cUDGk/usb-fanctl/preview/a_iso.png

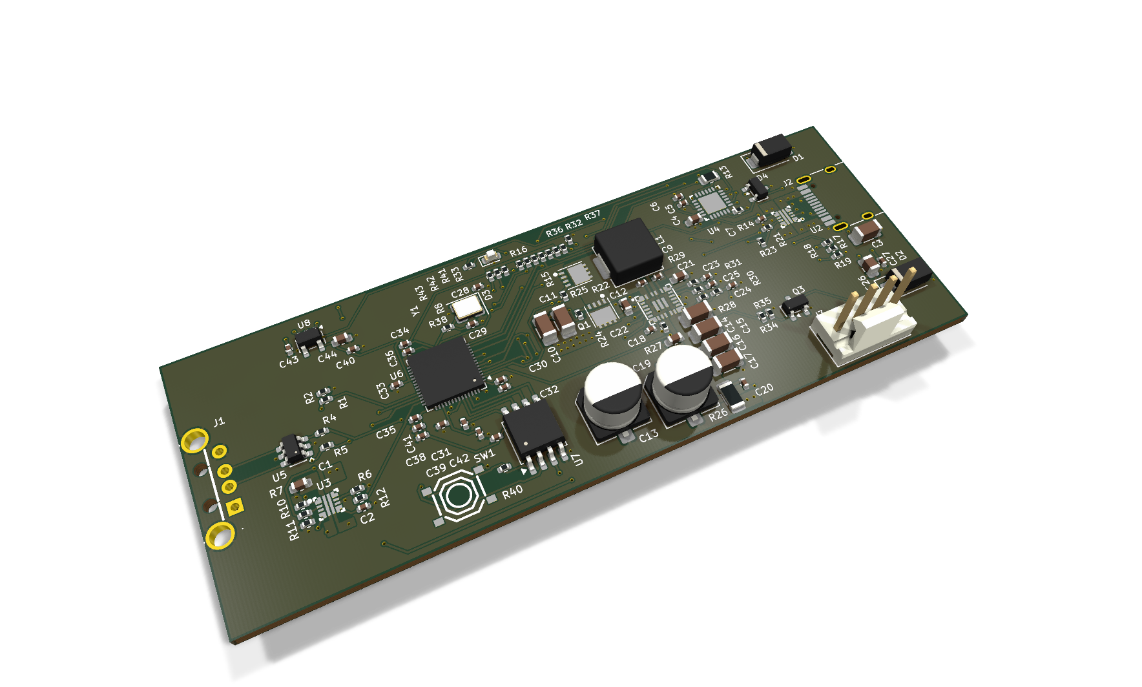
preview/a_iso.png
