cUDGk/usb-fanctl/preview/a_top.png

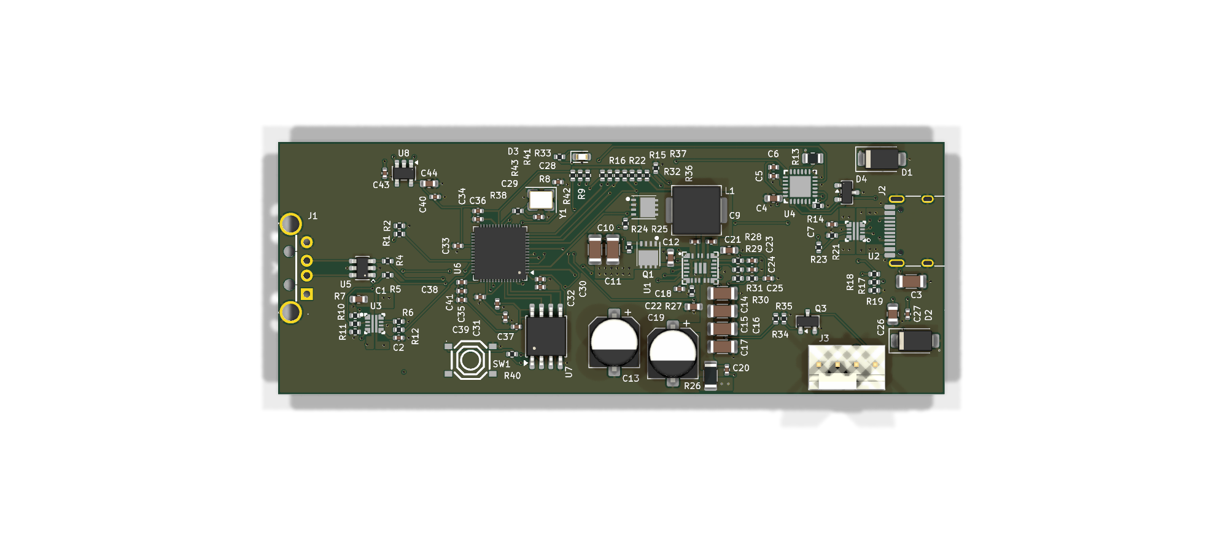
preview/a_top.png
