cUDGk/usb-fanctl/order/fanctl_c/jlc_placement_3d.png

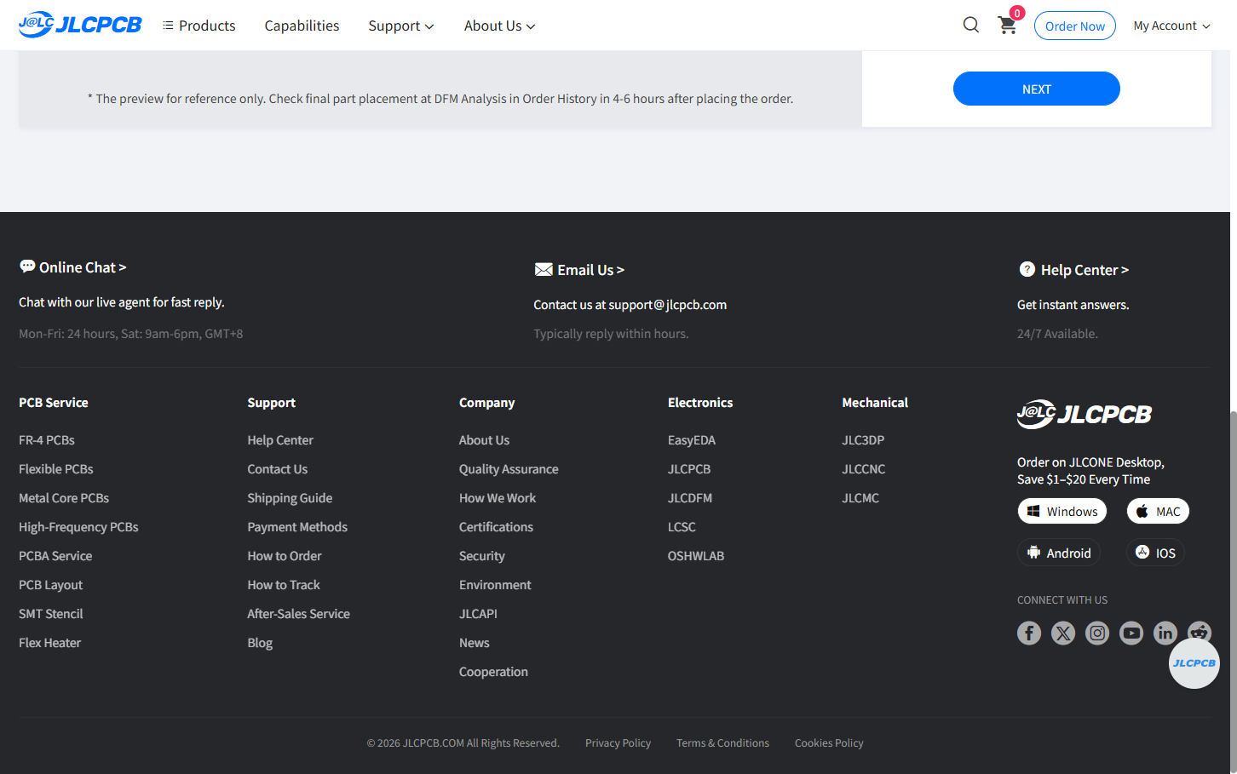
order/fanctl_c/jlc_placement_3d.png
