cUDGk/usb-fanctl/fanctl_c/fanctl_c.kicad_pcb

## KiCad design fanctl_c/fanctl_c.kicad_pcb (2026-09-18)

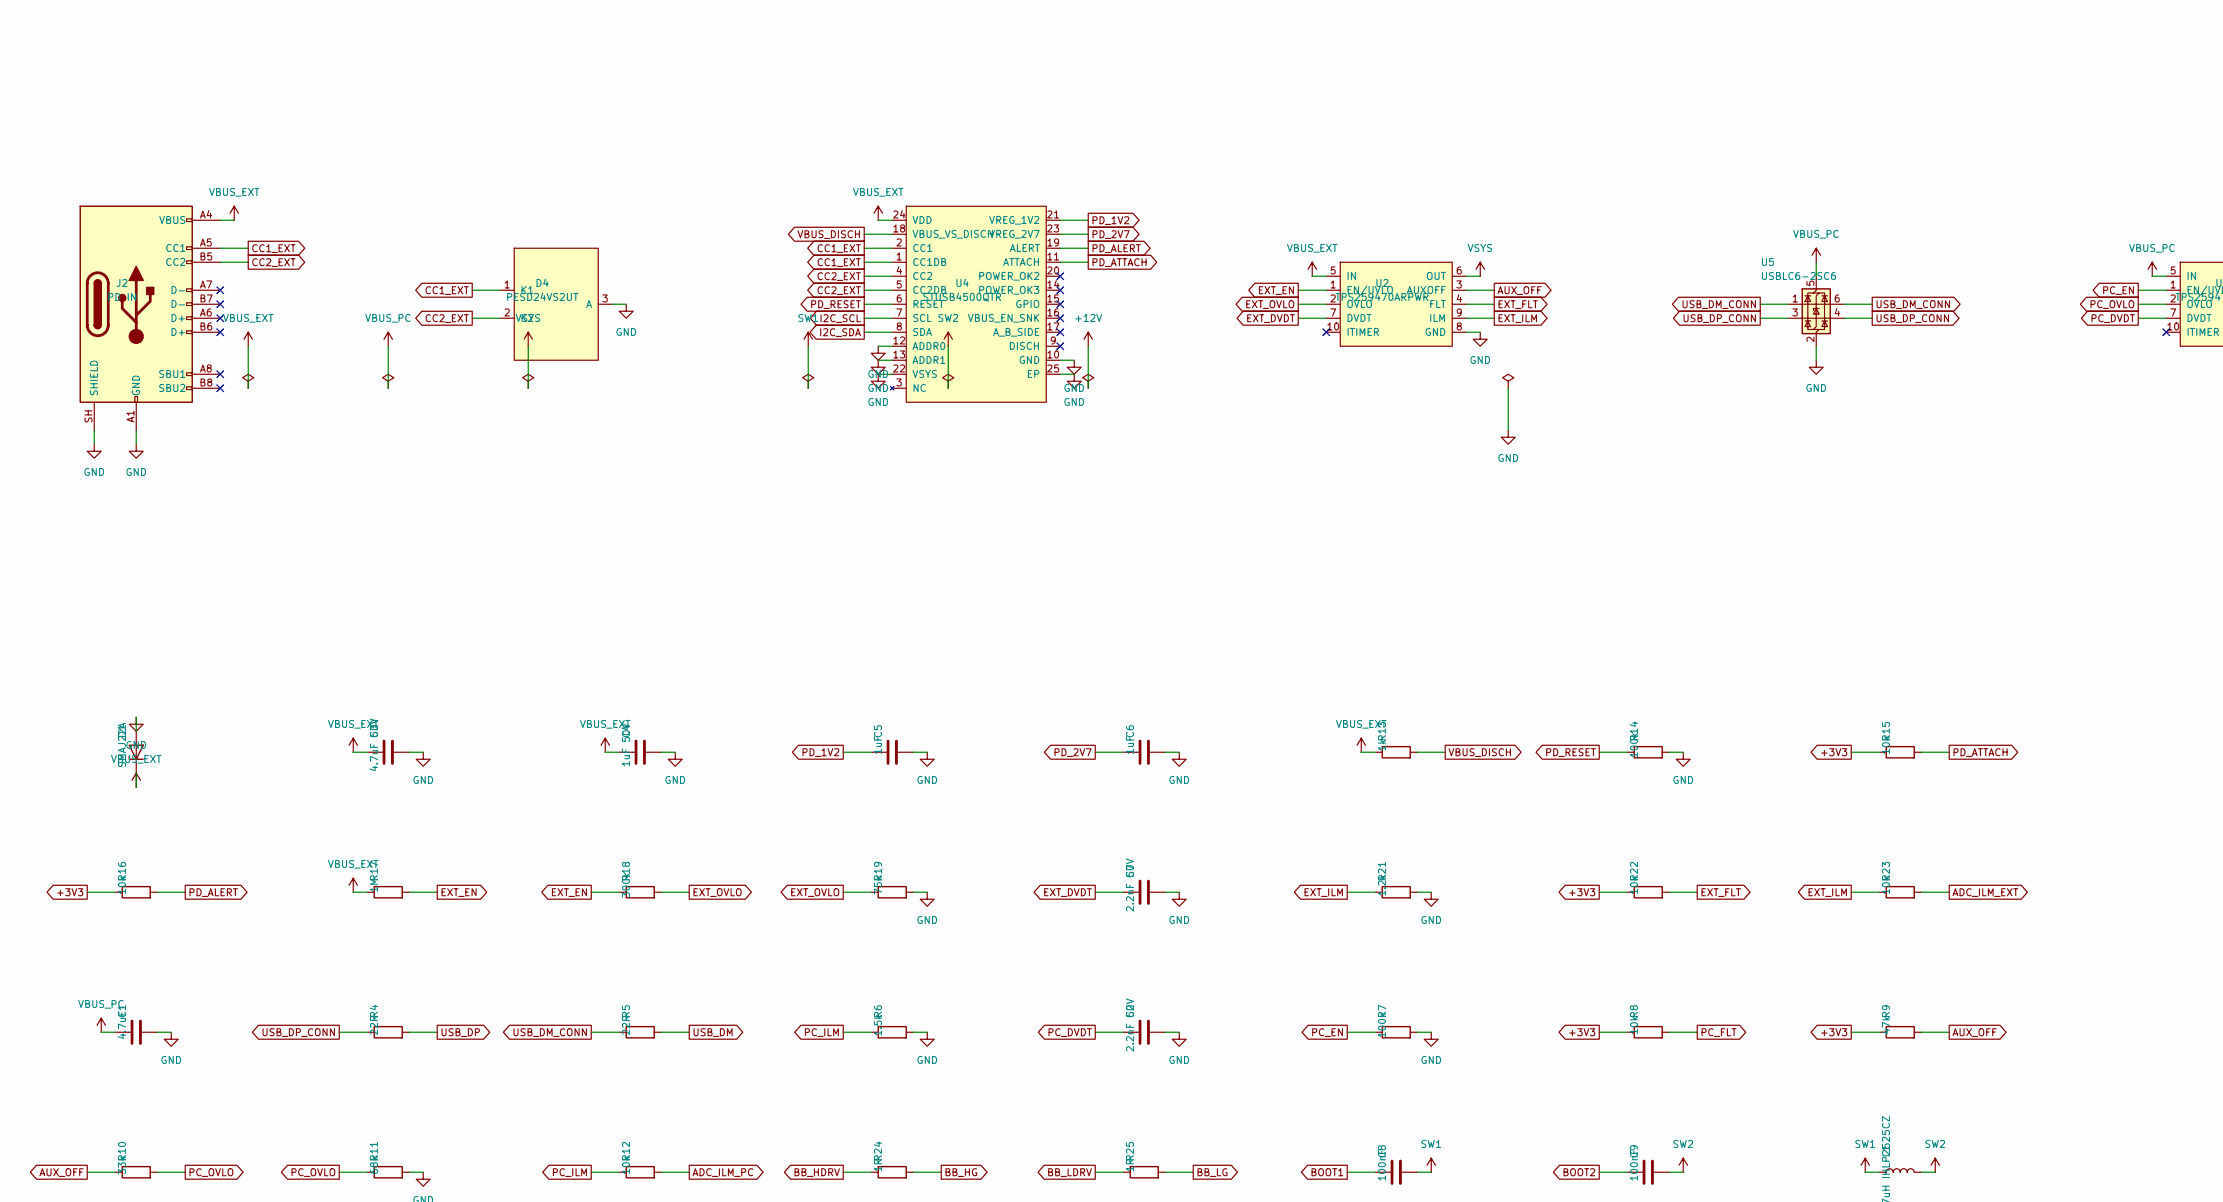
[picture p4: schematic fanctl_c.kicad_sch, USB Fan Controller (C plug), part in row 1, column 1]

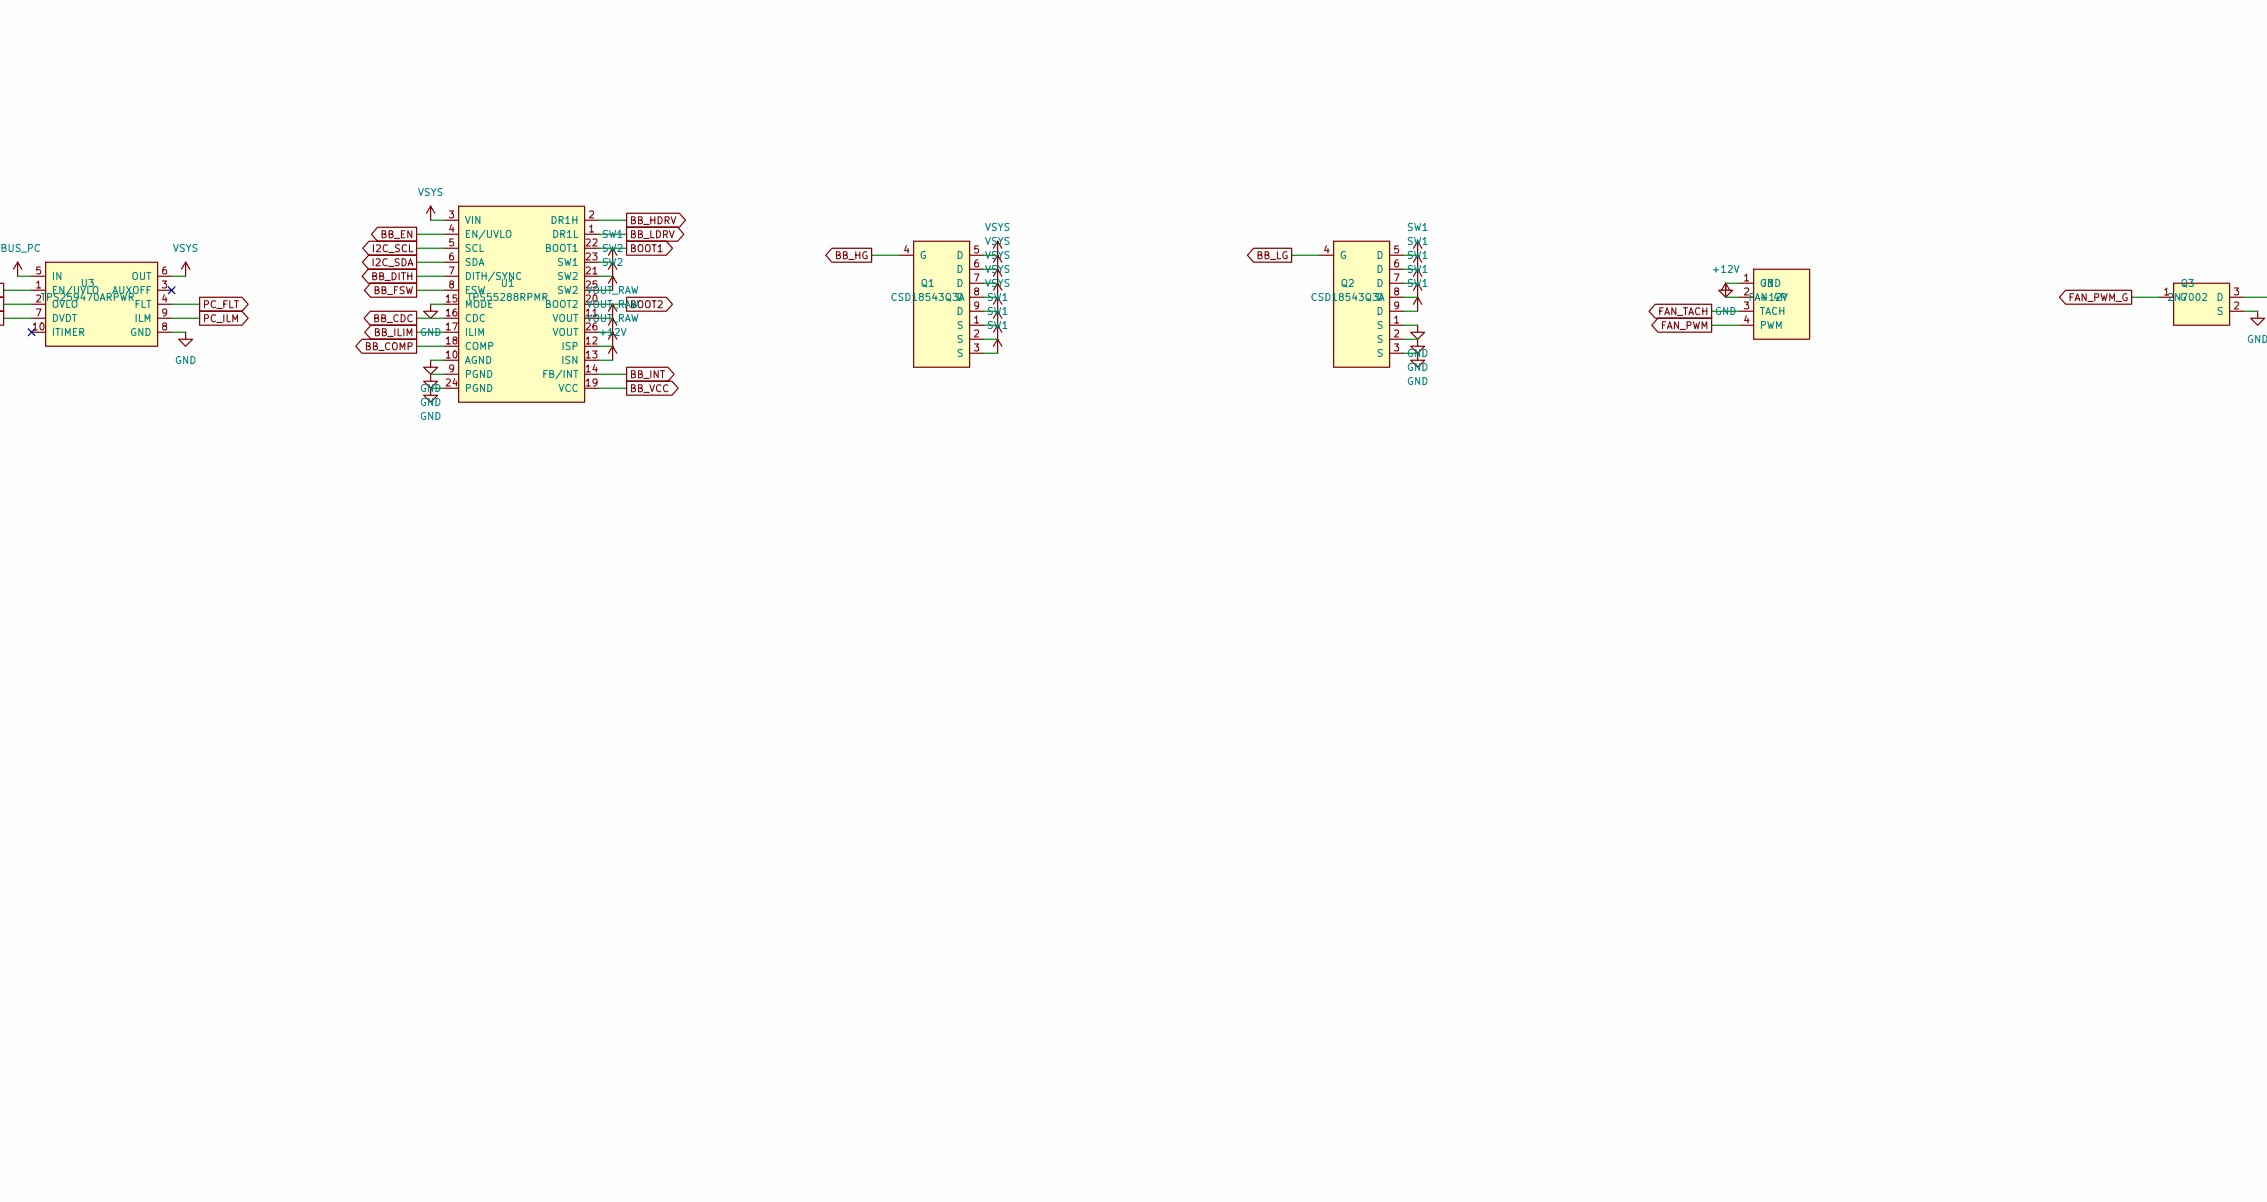
[picture p5: schematic fanctl_c.kicad_sch, USB Fan Controller (C plug), part in row 1, column 2]

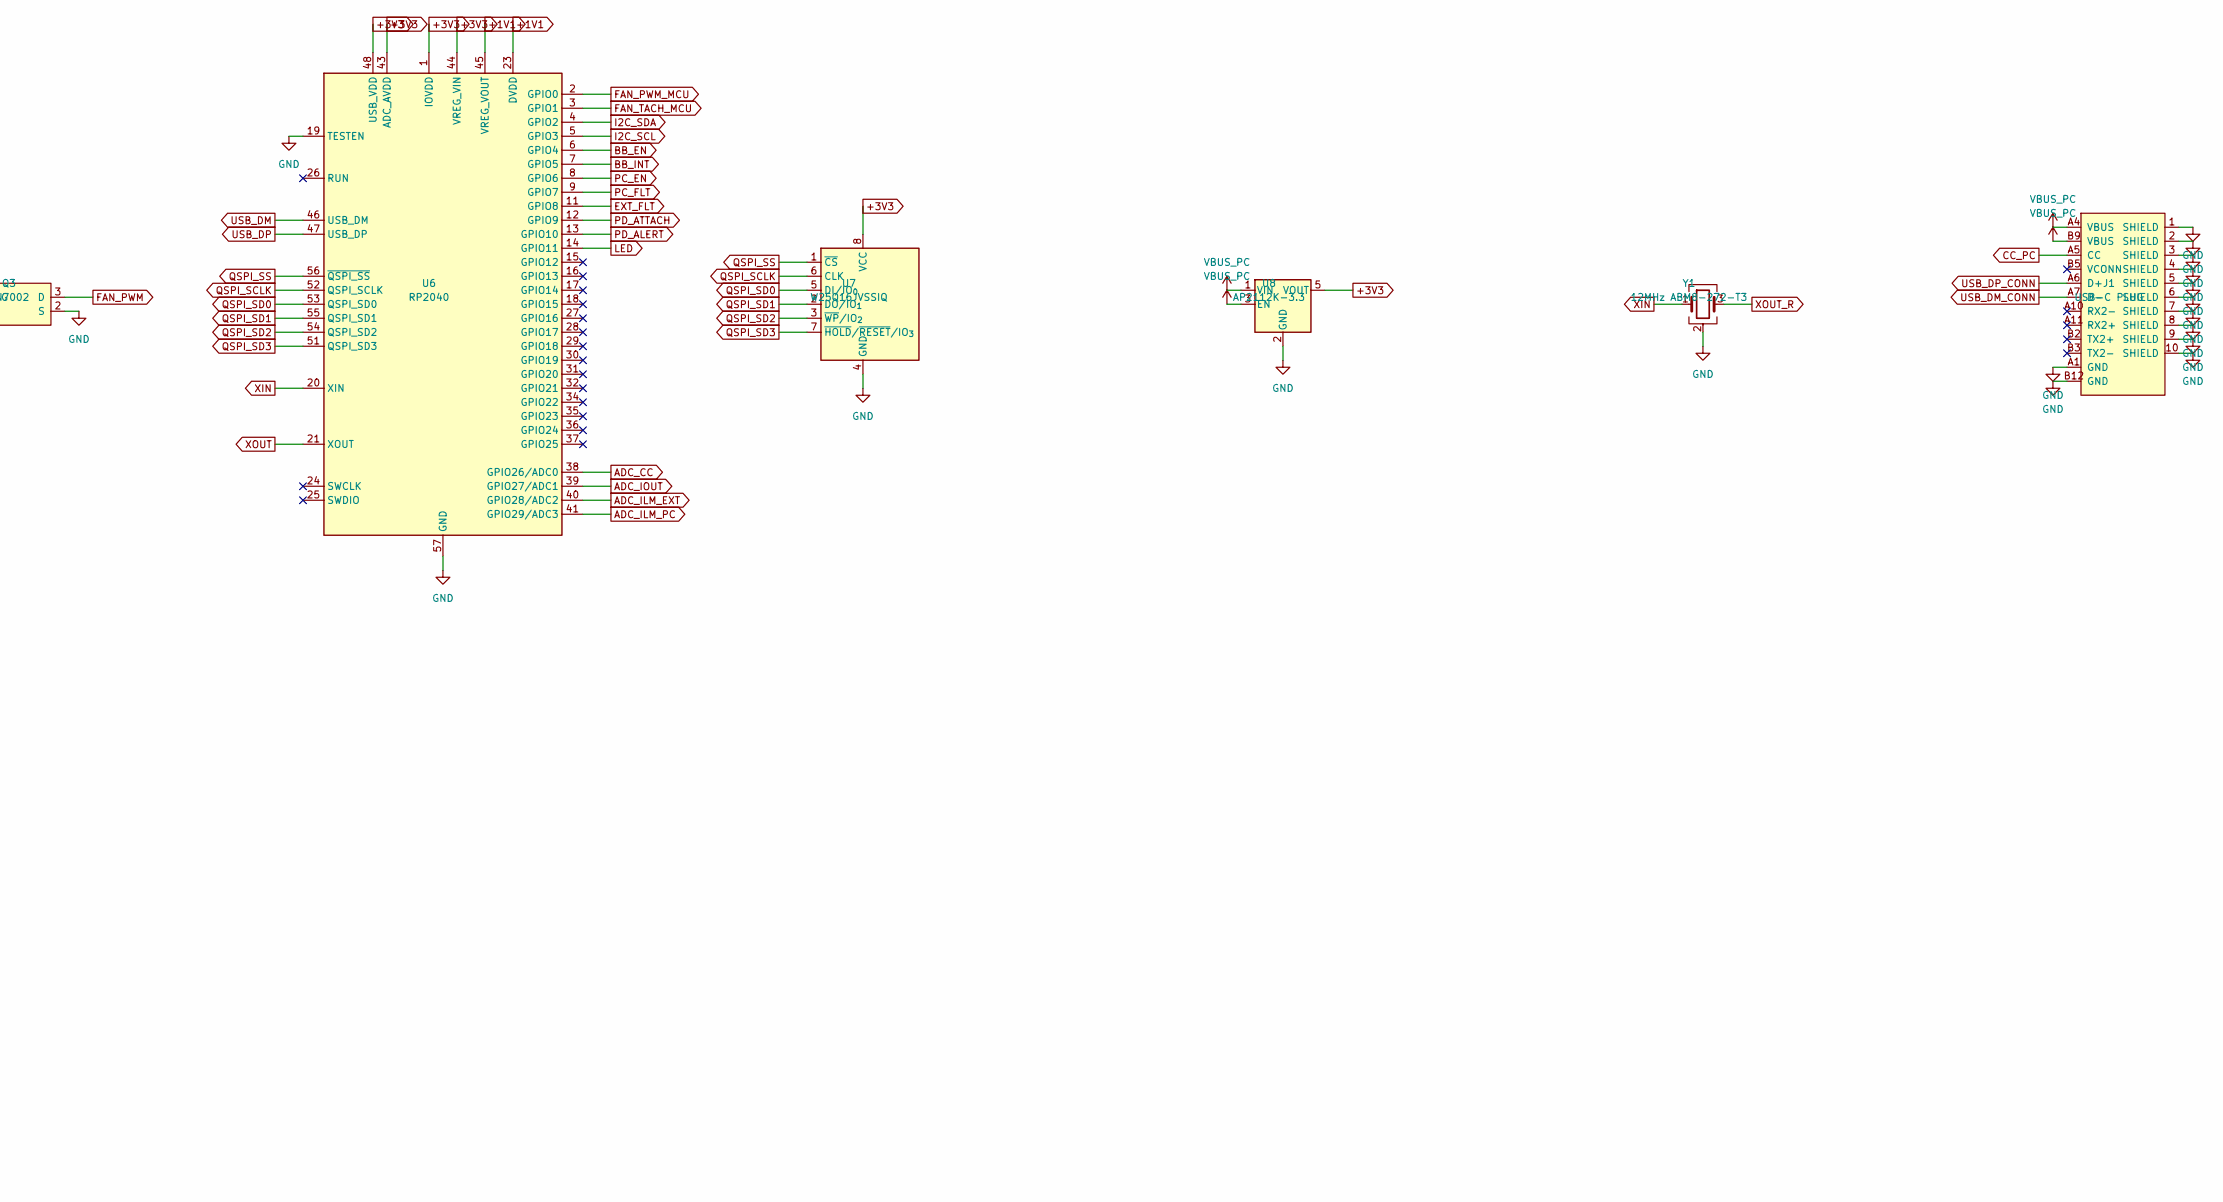
[picture p6: schematic fanctl_c.kicad_sch, USB Fan Controller (C plug), part in row 1, column 3]

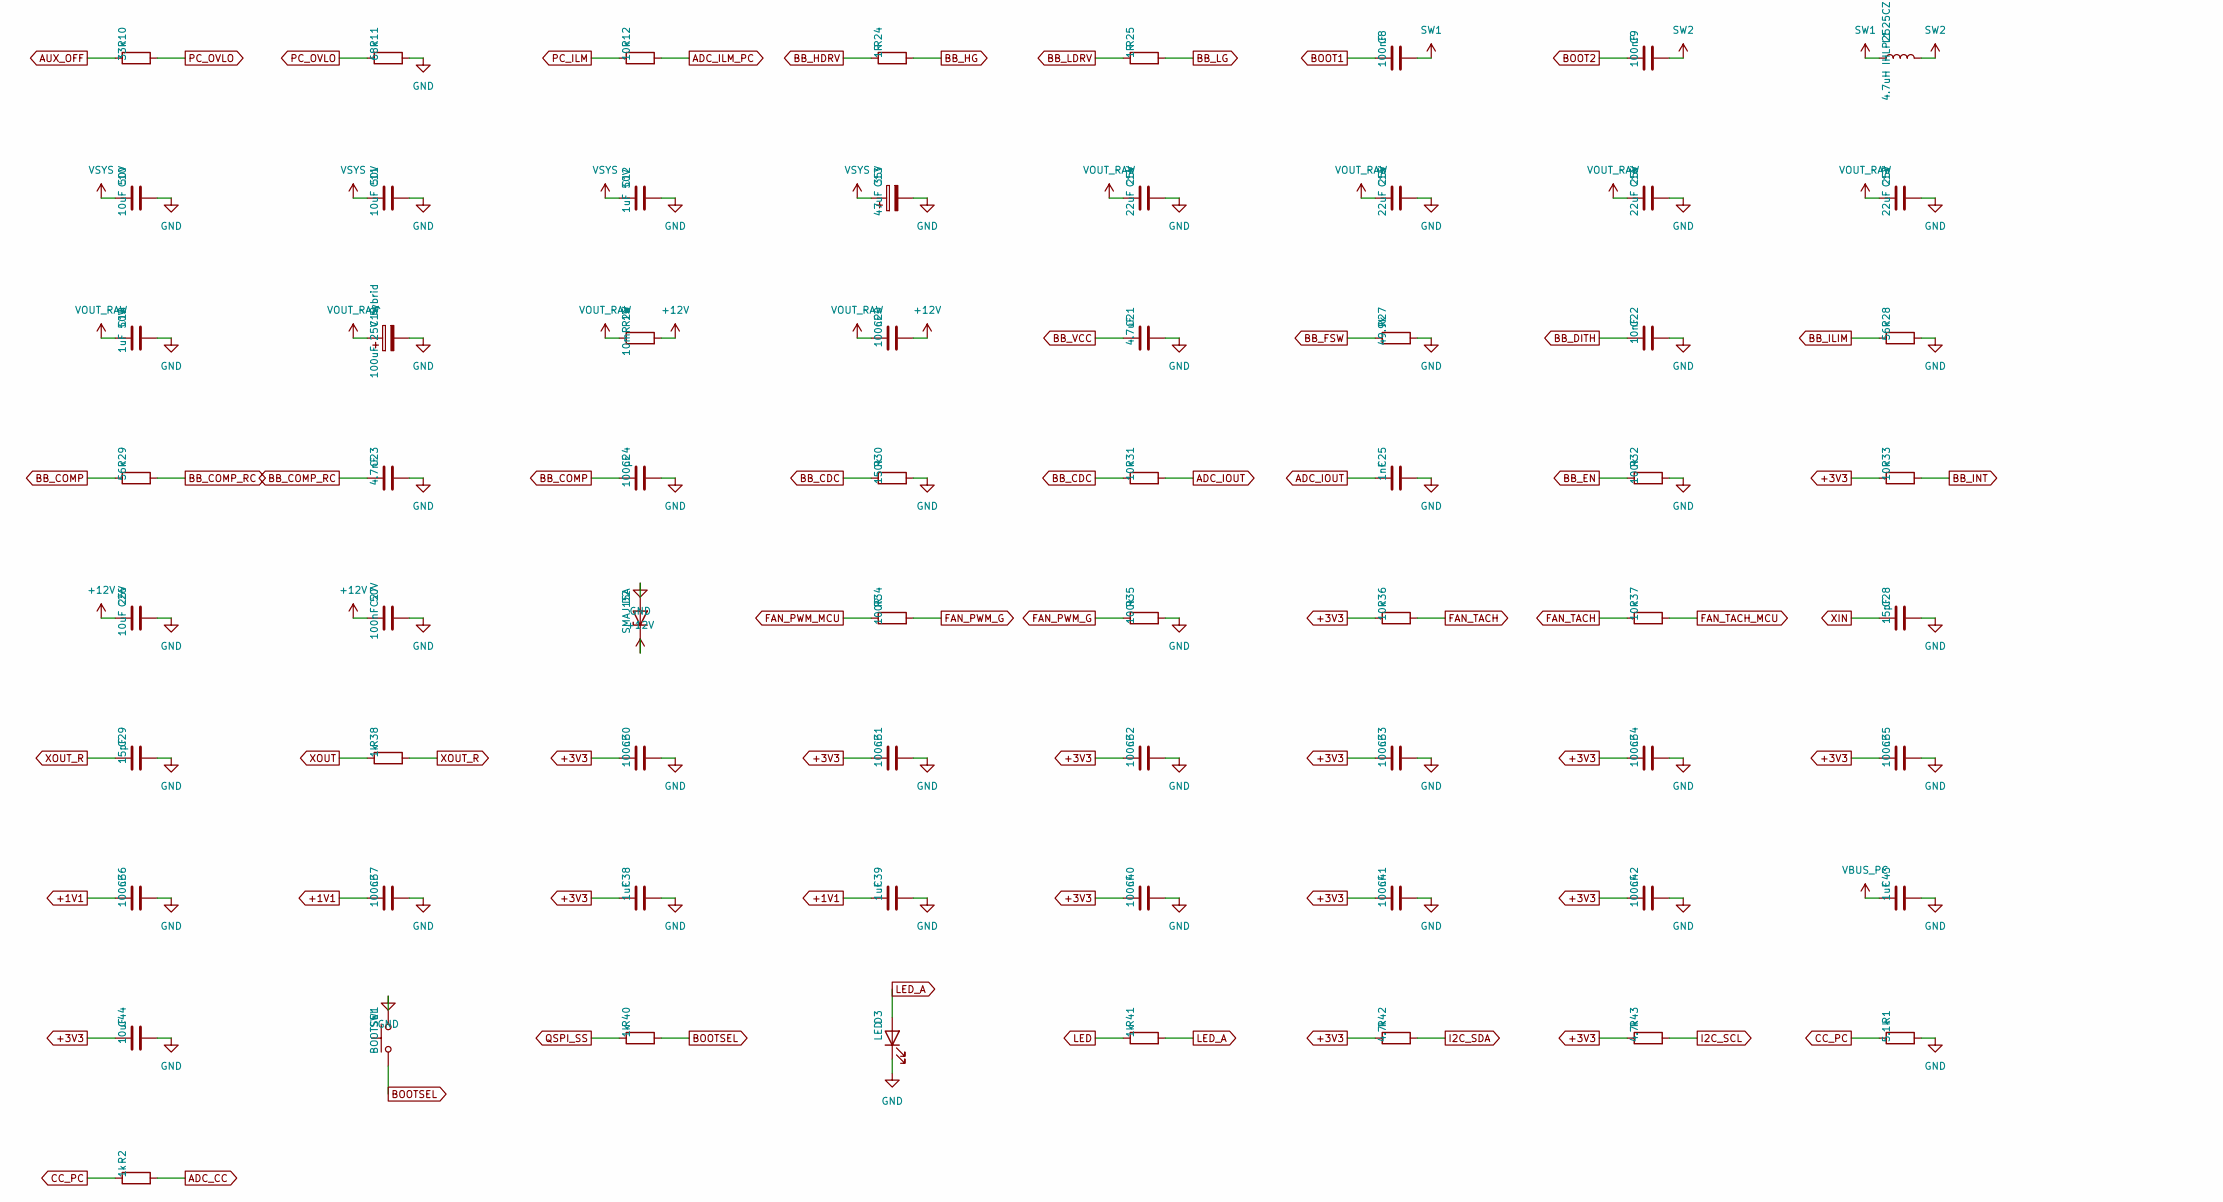
[picture p7: schematic fanctl_c.kicad_sch, USB Fan Controller (C plug), part in row 2, column 1]

Parts:
C1, C21: 4.7uF; C_0603_1608Metric
C2, C7: 2.2nF 50V; C_0402_1005Metric
C3: 4.7uF 50V; C_1206_3216Metric
C4, C12, C18: 1uF 50V; C_0603_1608Metric
C5, C6, C38, C39, C43: 1uF; C_0402_1005Metric
C8, C9, C20, C30, C31, C32, C33, C34, C35, C36, C37, C40, C41, C42: 100nF; C_0402_1005Metric
C10, C11: 10uF 50V; C_1206_3216Metric
C13: 47uF 35V; CP_Elec_6.3x5.4
C14, C15, C16, C17: 22uF 25V; C_1206_3216Metric
C19: 100uF 25V hybrid; CP_Elec_6.3x5.8
C22: 10nF; C_0402_1005Metric
C23: 4.7nF; C_0402_1005Metric
C24: 100pF; C_0402_1005Metric
C25: 1nF; C_0402_1005Metric
C26: 10uF 25V; C_0805_2012Metric
C27: 100nF 50V; C_0402_1005Metric
C28, C29: 15pF; C_0402_1005Metric
C44: 10uF; C_0603_1608Metric
D1: SMAJ22A; D_SMA
D2: SMAJ15A; D_SMA
D3: LED; LED_0603_1608Metric
D4: PESD24VS2UT; SOT-23
J1: USB-C PLUG; USB-C-SMD_TYPE-C-31-G-10
J2: PD IN; USB_C_Receptacle_HRO_TYPE-C-31-M-12
J3: FAN 4P; FanPinHeader_1x04_P2.54mm_Vertical
L1: 4.7uH IHLP2525CZ; L_Vishay_IHLP-2525
Q1, Q2: CSD18543Q3A; VSONP-8_L3.1-W3.1-P0.65-LS3.5-BL
Q3: 2N7002; SOT-23
R1: 5.1k; R_0402_1005Metric
R2, R38, R40, R41: 1k; R_0402_1005Metric
R4, R5: 22R; R_0402_1005Metric
R6: 1.5k; R_0402_1005Metric
R7, R14, R32, R35: 100k; R_0402_1005Metric
R8, R12, R15, R16, R22, R23, R31, R33, R36, R37: 10k; R_0402_1005Metric
R9: 47k; R_0402_1005Metric
R10: 33k; R_0402_1005Metric
R11: 68k; R_0402_1005Metric
R13: 1k; R_0805_2012Metric
R17: 1M; R_0402_1005Metric
R18: 300k; R_0402_1005Metric
R19: 75k; R_0402_1005Metric
R21: 1.2k; R_0402_1005Metric
R24, R25: 1R; R_0402_1005Metric
R26: 10mR 1W; R_1206_3216Metric
R27: 49.9k; R_0402_1005Metric
R28, R29: 56k; R_0402_1005Metric
R30: 150k; R_0402_1005Metric
R34: 100R; R_0402_1005Metric
R42, R43: 4.7k; R_0402_1005Metric
SW1: BOOTSEL; SW-SMD_4P-L5.1-W5.1-P3.70-LS6.5-TL_H1.5
U1: TPS55288RPMR; VQFN-HR-26_L4.0-W3.5_TPS55288RPMR
U2, U3: TPS259470ARPWR; VQFN-10_L2.0-W2.0-P0.45-TL
U4: STUSB4500QTR; QFN-24_L4.0-W4.0-P0.50-BL-EP2.8
U5: USBLC6-2SC6; SOT-23-6
U6: RP2040; QFN-56-1EP_7x7mm_P0.4mm_EP3.2x3.2mm
U7: W25Q16JVSSIQ; SOIC-8_5.3x5.3mm_P1.27mm
U8: AP2112K-3.3; SOT-23-5
Y1: 12MHz ABM8-272-T3; Crystal_SMD_3225-4Pin_3.2x2.5mm

Connections:
+1V1: C36.1, C37.1, C39.1, U6.23 (DVDD), U6.45 (VREG_VOUT), U6.50 (DVDD)
+3V3: C30.1, C31.1, C32.1, C33.1, C34.1, C35.1, C38.1, C40.1, C41.1, C42.1, C44.1, R8.1, R9.1, R15.1, R16.1, R22.1, R33.1, R36.1, R42.1, R43.1, U6.1 (IOVDD), U6.10 (IOVDD), U6.22 (IOVDD), U6.33 (IOVDD), U6.42 (IOVDD), U6.43 (ADC_AVDD), U6.44 (VREG_VIN), U6.48 (USB_VDD), U6.49 (IOVDD), U7.8 (VCC), U8.5 (VOUT)
+12V: C20.2, C26.1, C27.1, D2.1 (K), J3.2 (+12V), R26.2, U1.13 (ISN)
ADC_CC: R2.2, U6.38 (GPIO26/ADC0)
ADC_ILM_EXT: R23.2, U6.40 (GPIO28/ADC2)
ADC_ILM_PC: R12.2, U6.41 (GPIO29/ADC3)
ADC_IOUT: C25.1, R31.2, U6.39 (GPIO27/ADC1)
AUX_OFF: R9.2, R10.1, U2.3 (AUXOFF)
BB_CDC: R30.1, R31.1, U1.16 (CDC)
BB_COMP: C24.1, R29.1, U1.18 (COMP)
BB_COMP_RC: C23.1, R29.2
BB_DITH: C22.1, U1.7 (DITH/SYNC)
BB_EN: R32.1, U1.4 (EN/UVLO), U6.6 (GPIO4)
BB_FSW: R27.1, U1.8 (FSW)
BB_HDRV: R24.1, U1.2 (DR1H)
BB_HG: Q1.4 (G), R24.2
BB_ILIM: R28.1, U1.17 (ILIM)
BB_INT: R33.2, U1.14 (FB/INT), U6.7 (GPIO5)
BB_LDRV: R25.1, U1.1 (DR1L)
BB_LG: Q2.4 (G), R25.2
BB_VCC: C21.1, U1.19 (VCC)
BOOT1: C8.1, U1.22 (BOOT1)
BOOT2: C9.1, U1.20 (BOOT2)
BOOTSEL: R40.2, SW1.1
CC1_EXT: D4.1 (K1), J2.A5 (CC1), U4.1 (CC1DB), U4.2 (CC1)
CC2_EXT: D4.2 (K2), J2.B5 (CC2), U4.4 (CC2), U4.5 (CC2DB)
CC_PC: J1.A5 (CC), R1.1, R2.1
EXT_DVDT: C7.1, U2.7 (DVDT)
EXT_EN: R17.2, R18.1, U2.1 (EN/UVLO)
EXT_FLT: R22.2, U2.4 (FLT), U6.11 (GPIO8)
EXT_ILM: R21.1, R23.1, U2.9 (ILM)
EXT_OVLO: R18.2, R19.1, U2.2 (OVLO)
FAN_PWM: J3.4 (PWM), Q3.3 (D)
FAN_PWM_G: Q3.1 (G), R34.2, R35.1
FAN_PWM_MCU: R34.1, U6.2 (GPIO0)
FAN_TACH: J3.3 (TACH), R36.2, R37.1
FAN_TACH_MCU: R37.2, U6.3 (GPIO1)
GND: C1.2, C2.2, C3.2, C4.2, C5.2, C6.2, C7.2, C10.2, C11.2, C12.2, C13.2, C14.2, C15.2, C16.2, C17.2, C18.2, C19.2, C21.2, C22.2, C23.2, C24.2, C25.2, C26.2, C27.2, C28.2, C29.2, C30.2, C31.2, C32.2, C33.2, C34.2, C35.2, C36.2, C37.2, C38.2, C39.2, C40.2, C41.2, C42.2, C43.2, C44.2, D1.2 (A), D2.2 (A), D3.1 (K), D4.3 (A), J1.1 (SHIELD), J1.2 (SHIELD), J1.3 (SHIELD), J1.4 (SHIELD), J1.5 (SHIELD), J1.6 (SHIELD), J1.7 (SHIELD), J1.8 (SHIELD), J1.9 (SHIELD), J1.10 (SHIELD), J1.A1 (GND), J1.B12 (GND), J2.A1 (GND), J2.A12 (GND), J2.B1 (GND), J2.B12 (GND), J2.SH (SHIELD), J3.1 (GND), Q2.1 (S), Q2.2 (S), Q2.3 (S), Q3.2 (S), R1.2, R6.2, R7.2, R11.2, R14.2, R19.2, R21.2, R27.2, R28.2, R30.2, R32.2, R35.2, SW1.2, U1.9 (PGND), U1.10 (AGND), U1.15 (MODE), U1.24 (PGND), U2.8 (GND), U3.8 (GND), U4.10 (GND), U4.12 (ADDR0), U4.13 (ADDR1), U4.22 (VSYS), U4.25 (EP), U5.2 (GND), U6.19 (TESTEN), U6.57 (GND), U7.4 (GND), U8.2 (GND), Y1.2 (G), Y1.4 (G)
I2C_SCL: R43.2, U1.5 (SCL), U4.7 (SCL), U6.5 (GPIO3)
I2C_SDA: R42.2, U1.6 (SDA), U4.8 (SDA), U6.4 (GPIO2)
LED: R41.1, U6.14 (GPIO11)
LED_A: D3.2 (A), R41.2
PC_DVDT: C2.1, U3.7 (DVDT)
PC_EN: R7.1, U3.1 (EN/UVLO), U6.8 (GPIO6)
PC_FLT: R8.2, U3.4 (FLT), U6.9 (GPIO7)
PC_ILM: R6.1, R12.1, U3.9 (ILM)
PC_OVLO: R10.2, R11.1, U3.2 (OVLO)
PD_1V2: C5.1, U4.21 (VREG_1V2)
PD_2V7: C6.1, U4.23 (VREG_2V7)
PD_ALERT: R16.2, U4.19 (ALERT), U6.13 (GPIO10)
PD_ATTACH: R15.2, U4.11 (ATTACH), U6.12 (GPIO9)
PD_RESET: R14.1, U4.6 (RESET)
QSPI_SCLK: U6.52 (QSPI_SCLK), U7.6 (CLK)
QSPI_SD0: U6.53 (QSPI_SD0), U7.5 (DI/IO_{0})
QSPI_SD1: U6.55 (QSPI_SD1), U7.2 (DO/IO_{1})
QSPI_SD2: U6.54 (QSPI_SD2), U7.3 (~WP/IO_{2})
QSPI_SD3: U6.51 (QSPI_SD3), U7.7 (~HOLD/~RESET/IO_{3})
QSPI_SS: R40.1, U6.56 (~QSPI_SS), U7.1 (~CS)
SW1: C8.2, L1.1, Q1.1 (S), Q1.2 (S), Q1.3 (S), Q2.5 (D), Q2.6 (D), Q2.7 (D), Q2.8 (D), Q2.9 (D), U1.23 (SW1)
SW2: C9.2, L1.2, U1.21 (SW2), U1.25 (SW2)
USB_DM: R5.2, U6.46 (USB_DM)
USB_DM_CONN: J1.A7 (D-), R5.1, U5.1 (I/O1), U5.6 (I/O1)
USB_DP: R4.2, U6.47 (USB_DP)
USB_DP_CONN: J1.A6 (D+), R4.1, U5.3 (I/O2), U5.4 (I/O2)
VBUS_DISCH: R13.2, U4.18 (VBUS_VS_DISCH)
VBUS_EXT: C3.1, C4.1, D1.1 (K), J2.A4 (VBUS), J2.A9 (VBUS), J2.B4 (VBUS), J2.B9 (VBUS), R13.1, R17.1, U2.5 (IN), U4.24 (VDD)
VBUS_PC: C1.1, C43.1, J1.A4 (VBUS), J1.B9 (VBUS), U3.5 (IN), U5.5 (VBUS), U8.1 (VIN), U8.3 (EN)
VOUT_RAW: C14.1, C15.1, C16.1, C17.1, C18.1, C19.1, C20.1, R26.1, U1.11 (VOUT), U1.12 (ISP), U1.26 (VOUT)
VSYS: C10.1, C11.1, C12.1, C13.1, Q1.5 (D), Q1.6 (D), Q1.7 (D), Q1.8 (D), Q1.9 (D), U1.3 (VIN), U2.6 (OUT), U3.6 (OUT)
XIN: C28.1, U6.20 (XIN), Y1.1
XOUT: R38.1, U6.21 (XOUT)
XOUT_R: C29.1, R38.2, Y1.3

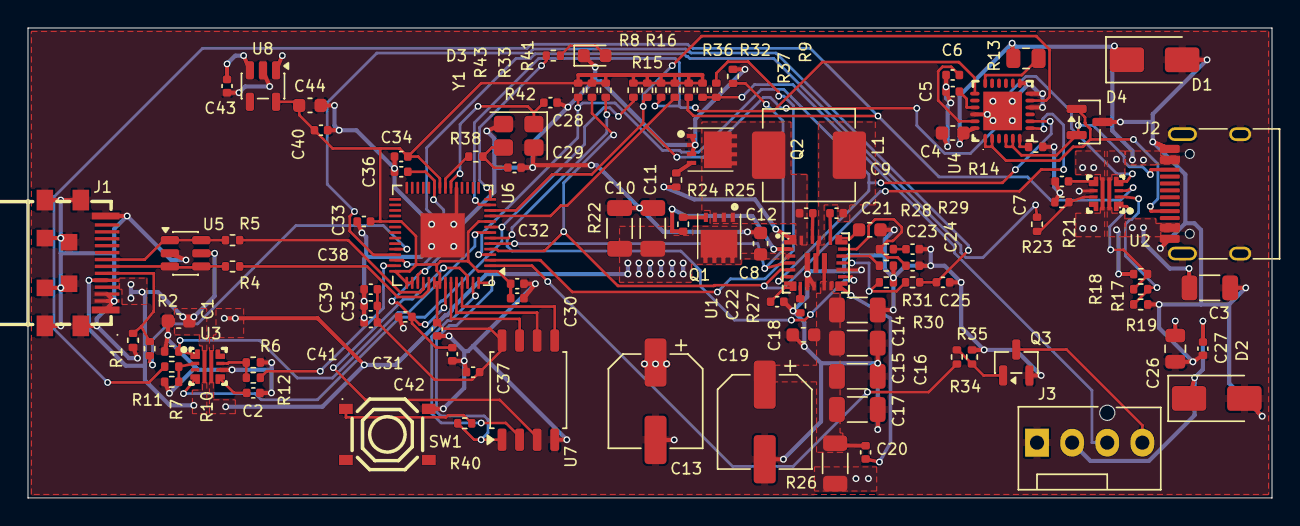
[picture p8: board fanctl_c.kicad_pcb from above]

Board: 4 copper layers, 90.0 x 34.0 mm, 105 parts (0 on the bottom side), 72 nets.
