cUDGk/usb-fanctl/(commit log)

2026-09-18 USB fan controller: Type-C / Type-A 2 variants with KiCad generators
    PC の USB から 5W/12W/30W クラスのファンを制御する基板。オス USB-C 版 (fanctl_c) と
    オス USB-A 版 (fanctl_a) の 2 種類を、circuit.py (回路) と pcb.py (配置・配線) の
    Python ジェネレータから生成する。
    - 4 層 90x34mm。In1=GND ベタ、In2=電源プレーン (VBUS_PC/VSYS/VBUS_EXT/+12V)
    - TPS55288 4 スイッチ昇降圧で PD 5-20V -> 12V、TPS259470A eFuse 2 個で
    PC 給電と外部 PD を優先度付き電源 MUX、STUSB4500 で PD ネゴシエーション
    - RP2040 + W25Q16 で Intel 4 線式ファン (PWM/TACH) を制御
    - C 版は DRC エラー 0 / 未接続 0。A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
    [fanctl_a-B_Cu.gbl, fanctl_a-B_Mask.gbs, fanctl_a-B_Silkscreen.gbo, fanctl_a-Edge_Cuts.gm1, fanctl_a-F_Cu.gtl, fanctl_a-F_Mask.gts, fanctl_a-F_Paste.gtp, fanctl_a-F_Silkscreen.gto]
2026-09-18 A variant: finish routing (0 DRC errors, 0 unconnected)
    USB-A 版で自動配線が抜けられなかったネットを手配線に切り替えて完結させた。
    - I2C (SCL/SDA): U1・MCU・プルアップが基板の端から端に散るため、2 本を平行レーンで手配線
    - ADC_IOUT / ADC_ILM_EXT: MCU 左側から基板東端まで、上辺の空き地を 2 レーンで横断
    - QSPI_SD2 / PC_FLT / EXT_OVLO: 混雑域からの脱出経路を決め打ち
    - 完全に手配線したネットは UNROUTED に入れて自動配線から除外
    freerouting の罠: 部品密集地帯 (x=163 付近) を縦断する裏面配線を DSN に入れると
    パス #4 以降でハングする。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
    [fanctl_a-B_Cu.gbl, fanctl_a-B_Mask.gbs, fanctl_a-B_Silkscreen.gbo, fanctl_a-Edge_Cuts.gm1, fanctl_a-F_Cu.gtl, fanctl_a-F_Mask.gts, fanctl_a-F_Paste.gtp, fanctl_a-F_Silkscreen.gto]
2026-09-19 Add NOTES.md: quotes, Economic PCBA cost-down plan, freerouting pitfalls
